TomaszUrban99/evaluation_boards/README.md

# evaluation_boards
A GitHub repository featuring example projects for various evaluation and development boards.
