TomaszUrban99/evaluation_boards/STM8S005K6CTR/parts_list.ods

LP | Description | Mouser No. | Manufacturer No. | Qty (needed) | Qty (ordered) | Price per Unit | Price (Total) | Category
1 | Switching Voltage Regulators HI EFF 500MA STEP- D OWN VLTG REG A 926-LM2671MX50NOPB | 926-LM2671M-5.0/NOPB | LM2671M-5.0/NOPB | 2 | 3 | 20.43 | 61.29 | Switching Voltage Regulators
2 | Power Inductors - SMD WE-TPC 1028 150uH .85A .53Ohm | 710-744065151 | 744065151 | 1 | 4 | 4.39 | 17.56 | Inductors
3 | Schottky Diodes & Rectifiers RECTIFIER SOD323F/SOD323F | 771-PMEG6010CEJ-T/R | PMEG6010CEJ,115 | 1 | 10 | 0.443 | 4.43 | Schottky Diode
4 | Aluminium Electrolytic Capacitors - Radial Leaded WCAP-PT5H 120uF 35V 20% Radial | 710-870235675006 | 870235675006 | 1 | 5 | 6.49 | 32.45 | Capacitors
5 | Aluminium Electrolytic Capacitors - Radial Leaded 100VDC 100uF 20% L/S=5mm | 667-EEU-FR2A101 | EEU-FR2A101 | 1 | 10 | 2.25 | 22.5 | Capacitors
6 | Multilayer Ceramic Capacitors MLCC - SMD/SMT 0.01 uF 50 VDC 10% 0603 X7R AEC-Q200 | 81-GCM188R71H103KA7J | GCM188R71H103KA37J | 1 | 20 | 0.163 | 3.26 | Capacitors
7 | Tactile Switches 4.5X4.5mm, 2.5N, Total Height 7mm, IP5X | 611-PTS647SK70SMTR2N | PTS647SK70SMTR2N LFS |  |  |  | 0
8 | Crystals 8.000 MHz 8pF +/-10/150 ppm -40 - +150C +/-2 ppm Aging AEC-Q200 ECX-33B2Q RoHS | 520-80833B2QCVYTR | ECS-80-8-33B2Q-CVY-TR3 | 1 | 10 | 1.65 | 16.5 | Crystal
9 | Multilayer Ceramic Capacitors MLCC - SMD/SMT 100V 0.1uF 10% X7R -55 / +125 0805 AEC-Q200 | 80-C0805Y104K1RACAUT C0805Y104K1RACAUTO |  | 4 | 20 | 0.727 | 14.54 | Capacitors
10 | Aluminium Electrolytic Capacitors - Radial Leaded WCAP-ATG5 1uF 63V 20% Radia | 710-860020772005 | 860020772005 | 1 | 10 | 0.439 | 4.39 | Capacitors
11 | Multilayer Ceramic Capacitors MLCC - SMD/SMT Automotive Grade,MLCC,0603,X7R,50V,1uF,+/-10%,0.8mm | 810-CGA3E3X7R1H105K0 | CGA3E3X7R1H105K080AB | 1 | 10 | 0.701 | 7.01 | Capacitors
12 | LDO Voltage Regulators Ultra-Low Noise 200mA LDO | 584-ADPL40502AUJZ33R | ADPL40502AUJZ-3.3-R7 | 2 | 10 | 1.79 | 17.9 | LDO Voltage Regulators
13 | Multilayer Ceramic Capacitors MLCC - SMD/SMT CGA 0603 50V 0.1uF X7R 10% AEC-Q200 | 810-CGA3E2X7R1H104K | CGA3E2X7R1H104K080AA | 10 | 100 | 0.095 | 9.5 | Capacitors
14 | Tantalum Capacitors - Solid SMD 35V 1uF 10% | 581-TRJB105K035RRJ | TRJB105K035RRJ | 1 | 10 | 1.57 | 15.7 | Capacitors
15 | Multilayer Ceramic Capacitors MLCC - SMD/SMT 50V 6pF C0G 0402 0.25pF | 80-C0402C609C5GACTU | C0402C609C5GACTU | 2 | 20 | 0.667 | 13.34 | Capacitors
16 |  |  |  |  |  |  | 0
 |  |  |  |  |  |  | 0
