TomaszUrban99/evaluation_boards/components/ADPL40502AUJZ-3.3-R7/3D/ADPL40502AUJZ-3.3-R7.stp

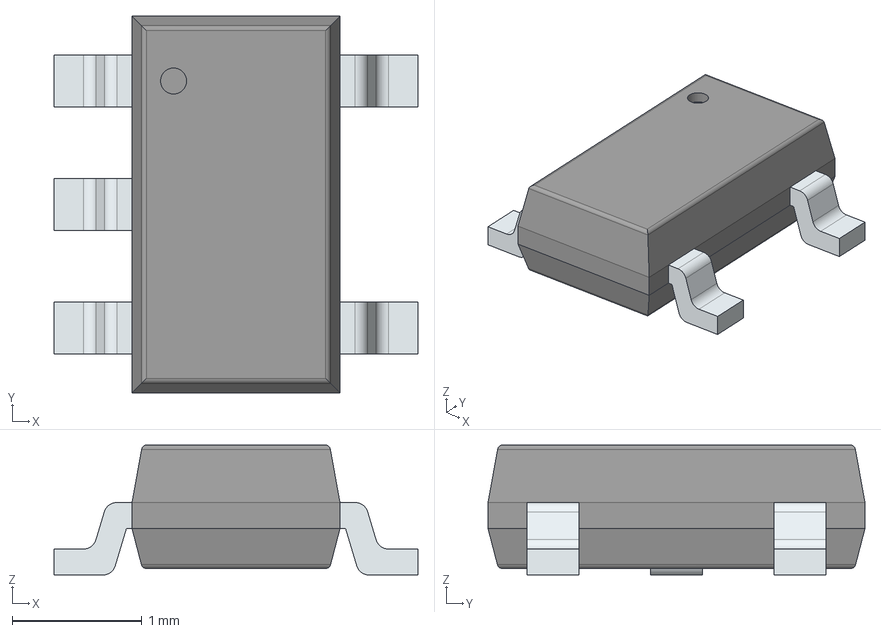
[picture p1: CAD file, 2025-09-21]
components/ADPL40502AUJZ-3.3-R7/3D/ADPL40502AUJZ-3.3-R7.stp
2.80 x 2.90 x 1.00 mm
PinsArrayL
PinsArrayR
