TomaszUrban99/evaluation_boards/components/ECS-80-8-33B2Q-CVY-TR3/3D/ECS-80-8-33B2Q-CVY-TR3.stp

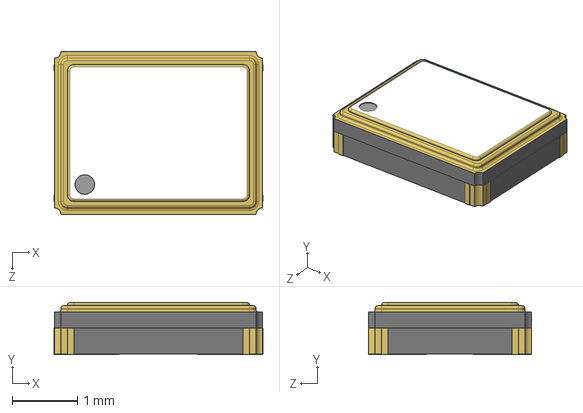
[picture p2: CAD file, 2025-09-21]
components/ECS-80-8-33B2Q-CVY-TR3/3D/ECS-80-8-33B2Q-CVY-TR3.stp
3.21 x 0.8 x 2.51 mm
