TomaszUrban99/evaluation_boards/components/L6981C50DR/3D/L6981C50DR.stp

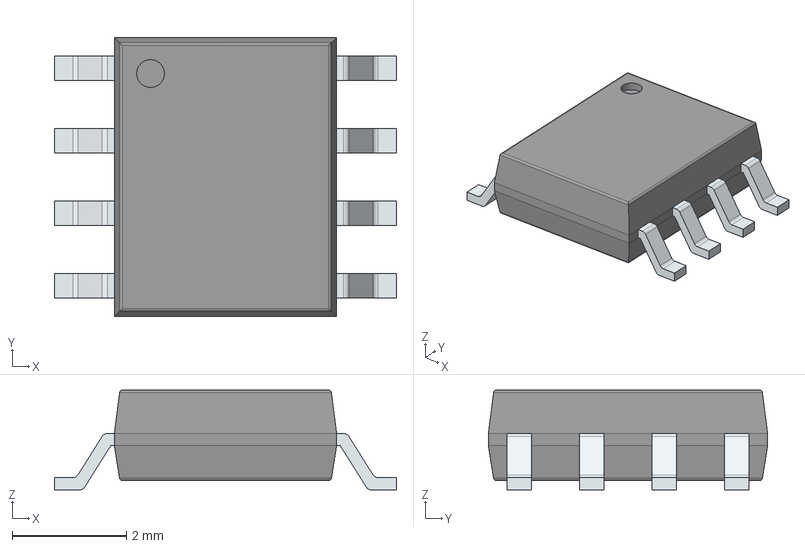
[picture p3: CAD file, 2025-09-05]
components/L6981C50DR/3D/L6981C50DR.stp
6.00 x 4.90 x 1.75 mm
PinsArrayLR
