TomaszUrban99/evaluation_boards/components/LM2671M-5.0_NOPB/3D/LM2671M-5.0_NOPB.stp

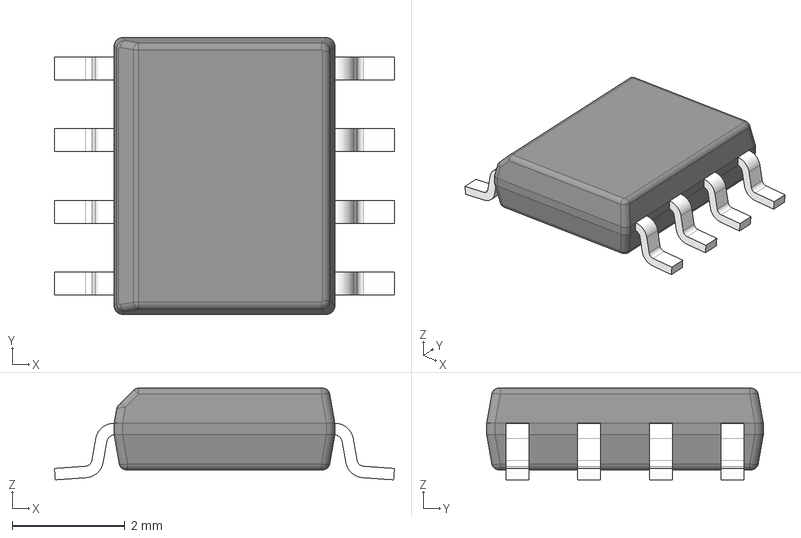
[picture p4: CAD file, 2025-09-11]
components/LM2671M-5.0_NOPB/3D/LM2671M-5.0_NOPB.stp
6.02 x 4.90 x 1.63 mm
BODY-SO
LEAD-D0008A x 8
