TomaszUrban99/evaluation_boards/components/PTS647SK70SMTR2N_LFS/3D/PTS647SK70SMTR2N_LFS.stp

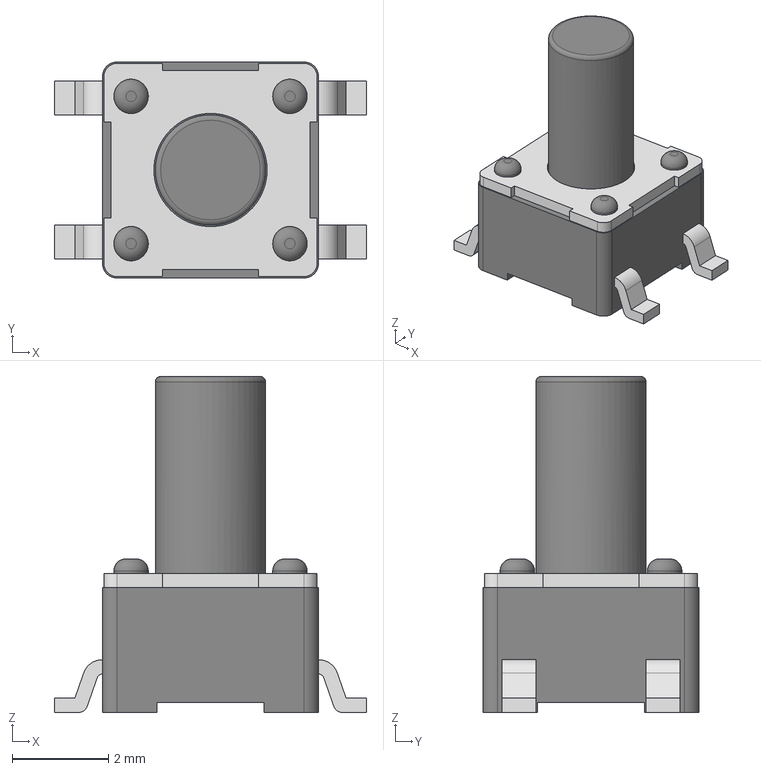
[picture p5: CAD file, 2025-09-14]
components/PTS647SK70SMTR2N_LFS/3D/PTS647SK70SMTR2N_LFS.stp
6.50 x 4.50 x 7.00 mm
