TomaszUrban99/evaluation_boards/components/STM8S005K6T6CTR/3D/STM8S005K6T6CTR.stp

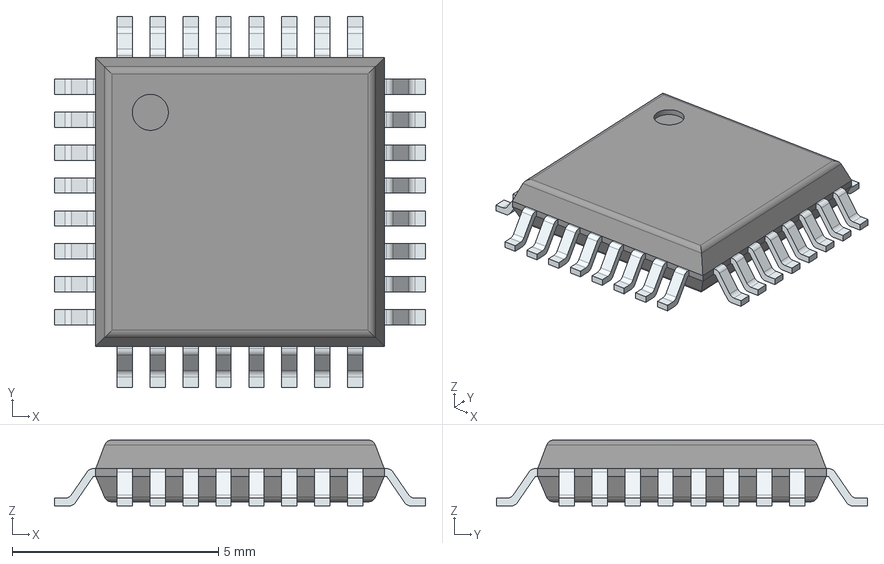
[picture p6: CAD file, 2025-09-05]
components/STM8S005K6T6CTR/3D/STM8S005K6T6CTR.stp
9.00 x 9.00 x 1.60 mm
PinsArrayLR
PinsArrayTB
