TomaszUrban99/evaluation_boards/components/282837-2/3D/282837-2.stp

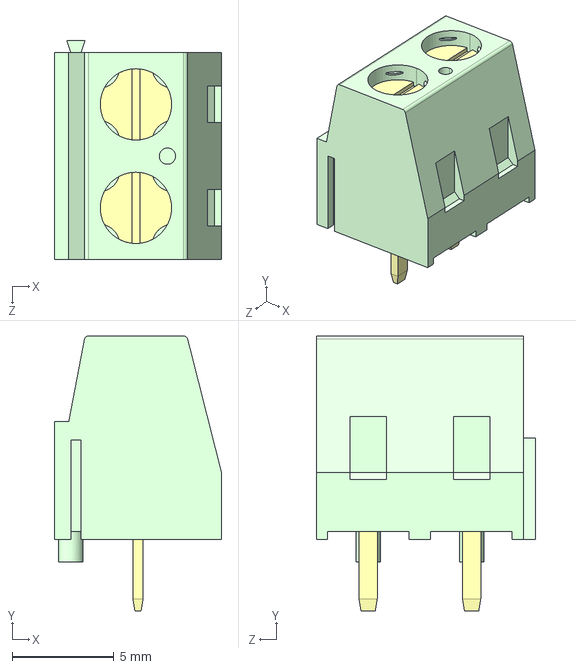
[picture p7: CAD file, 2025-09-05]
components/282837-2/3D/282837-2.stp
8.20 x 13.5 x 10.8 mm
