TomaszUrban99/evaluation_boards/components/744065151/3D/744065151.stp

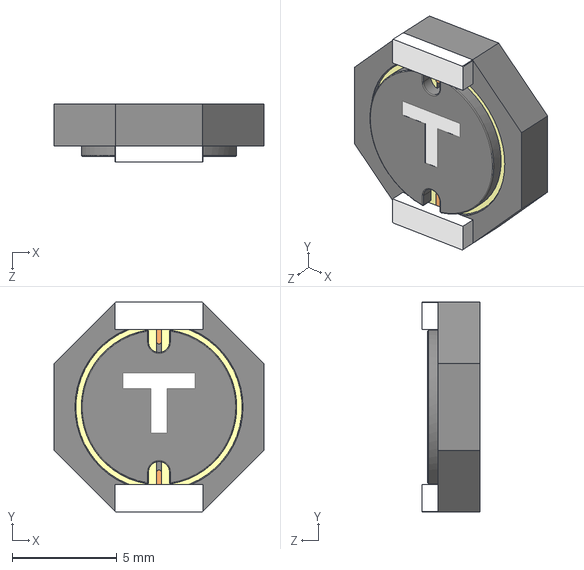
[picture p8: CAD file, 2025-09-11]
components/744065151/3D/744065151.stp
10.0 x 10.0 x 2.78 mm
