TomaszUrban99/evaluation_boards/components/830029914/3D/830029914.stp

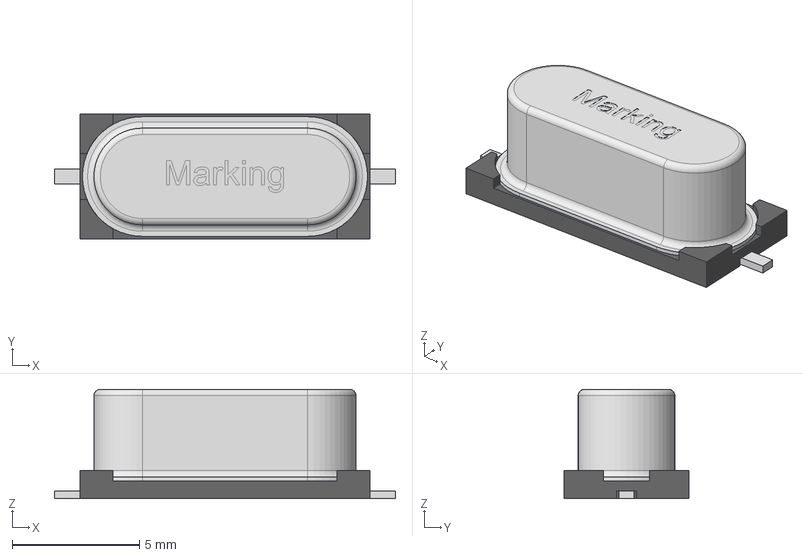
[picture p9: CAD file, 2025-09-14]
components/830029914/3D/830029914.stp
13.4 x 4.90 x 4.30 mm
Base
Housing
