TomaszUrban99/evaluation_boards/(list of files, cad)

Other CAD files:
components/830029914/Allegro/830029914.psm
components/830029914/DEHDL/830029914/chips/chips.prt
