TomaszUrban99/evaluation_boards/STM8S005K6CTR/STM8S005k6T6CTR.kicad_pcb

## KiCad design STM8S005K6CTR/STM8S005k6T6CTR.kicad_pcb (2025-09-25)

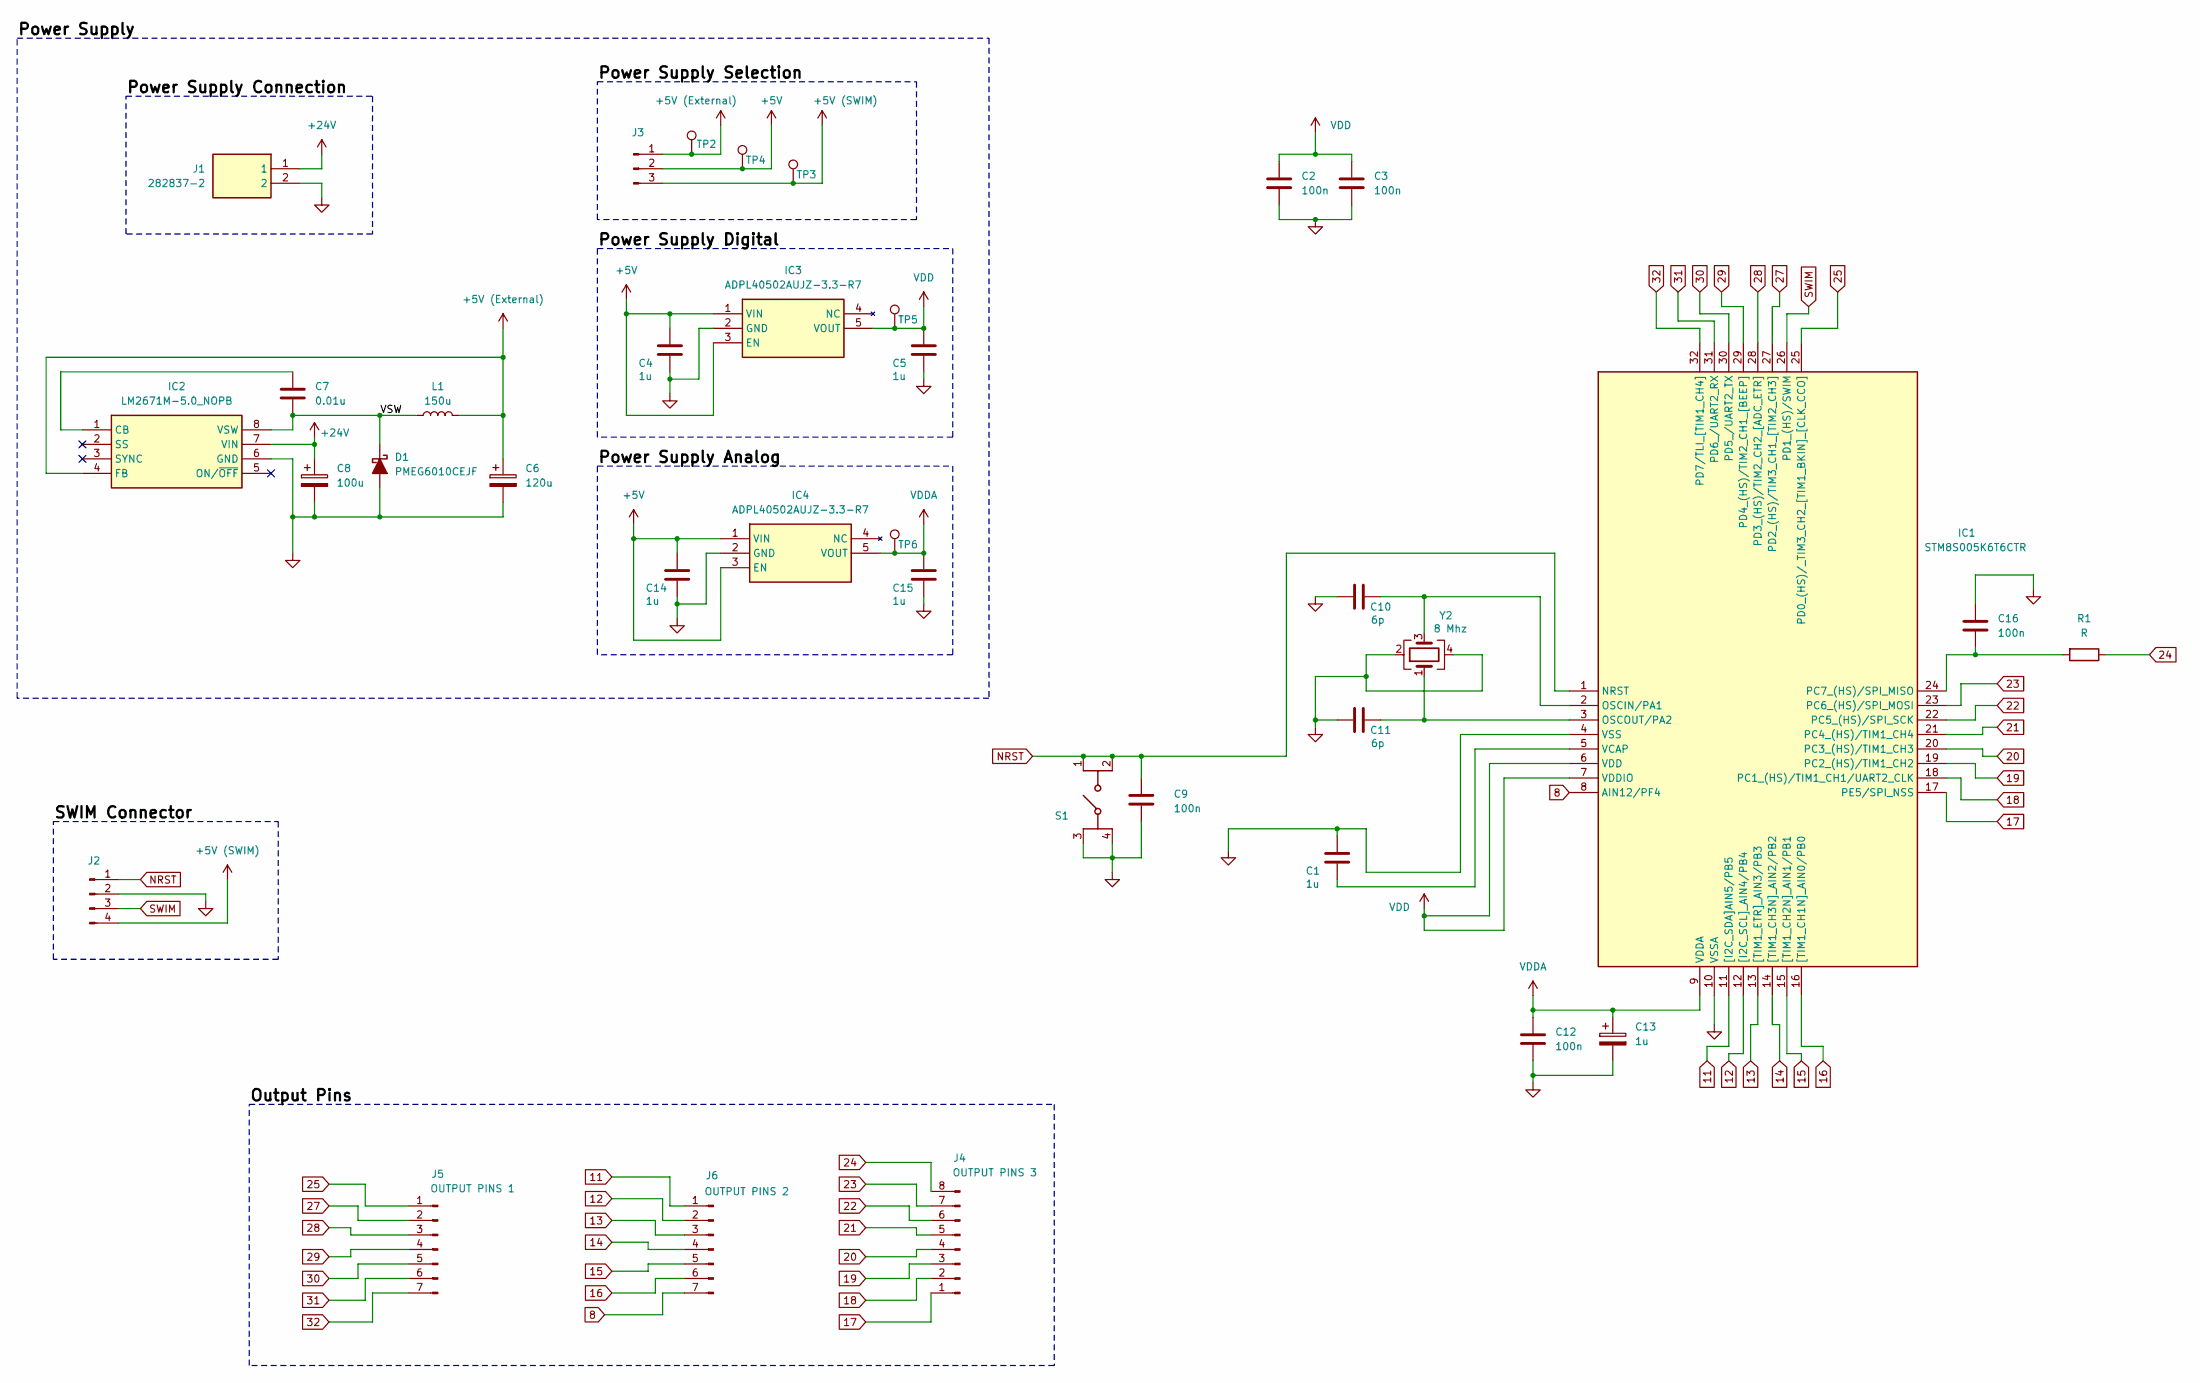
[picture p10: schematic STM8S005k6T6CTR.kicad_sch]

Parts:
C1, C4, C5, C14, C15: 1u; C_0603_1608Metric
C2, C3, C9, C12, C16: 100n; C_0603_1608Metric
C6: 120u; CP_Radial_D10.0mm_P5.00mm
C7: 0.01u; C_0603_1608Metric
C8: 100u; CP_Radial_D10.0mm_P5.00mm
C10, C11: 6p; C_0402_1005Metric
C13: 1u; C_1210_3225Metric
D1: PMEG6010CEJF; D_SOD-323F
IC1: STM8S005K6T6CTR; QFP80P900X900X160-32N; Mouser Part Number 511-STM8S005K6T6CTR
IC2: LM2671M-5.0_NOPB; SOIC127P600X175-8N; Mouser Part Number 926-LM2671M-5.0/NOPB
IC3, IC4: ADPL40502AUJZ-3.3-R7; SOT95P280X100-5N; Mouser Part Number 584-ADPL40502AUJZ33R
J1: 282837-2; 2828372; Mouser Part Number 571-2828372
J2: Conn_01x04_Pin; PinHeader_1x04_P2.54mm_Vertical
J3: Conn_01x03_Pin; PinHeader_1x03_P2.54mm_Vertical
J4: Conn_01x08_Pin; PinSocket_1x08_P2.54mm_Vertical
J5, J6: Conn_01x07_Pin; PinSocket_1x07_P2.54mm_Vertical
L1: 150u; WE-TPC_1028_103892
R1: R
S1: PTS647SK70SMTR2N_LFS; PTS647SK70SMTR2NLFS; Manufacturer_Part_Number PTS647SK70SMTR2N LFS
TP2, TP3, TP4, TP5, TP6: TestPoint; TestPoint_Pad_D1.5mm
Y2: 8 Mhz; ECS80833B2QCVYTR3

Connections:
8: IC1.8 (AIN12/PF4), J6.7
11: IC1.11 ([I2C_SDA]AIN5/PB5), J6.1
12: IC1.12 ([I2C_SCL]_AIN4/PB4), J6.2
13: IC1.13 ([TIM1_ETR]_AIN3/PB3), J6.3
14: IC1.14 ([TIM1_CH3N]_AIN2/PB2), J6.4
15: IC1.15 ([TIM1_CH2N]_AIN1/PB1), J6.5
16: IC1.16 ([TIM1_CH1N]_AIN0/PB0), J6.6
17: IC1.17 (PE5/SPI_NSS), J4.1
18: IC1.18 (PC1_(HS)/TIM1_CH1/UART2_CLK), J4.2
19: IC1.19 (PC2_(HS)/TIM1_CH2), J4.3
20: IC1.20 (PC3_(HS)/TIM1_CH3), J4.4
21: IC1.21 (PC4_(HS)/TIM1_CH4), J4.5
22: IC1.22 (PC5_(HS)/SPI_SCK), J4.6
23: IC1.23 (PC6_(HS)/SPI_MOSI), J4.7
24: J4.8, R1.1
25: IC1.25 (PD0_(HS)/_TIM3_CH2_[TIM1_BKIN]_[CLK_CCO]), J5.1
27: IC1.27 (PD2_(HS)/TIM3_CH1_[TIM2_CH3]), J5.2
28: IC1.28 (PD3_(HS)/TIM2_CH2_[ADC_ETR]), J5.3
29: IC1.29 (PD4_(HS)/TIM2_CH1_[BEEP]), J5.4
30: IC1.30 (PD5_/UART2_TX), J5.5
31: IC1.31 (PD6_/UART2_RX), J5.6
32: IC1.32 (PD7/TLI_[TIM1_CH4]), J5.7
+5V: C4.1, C14.1, IC3.1 (VIN), IC3.3 (EN), IC4.1 (VIN), IC4.3 (EN), J3.2, TP4.1
+5V (External): C6.1, IC2.4 (FB), J3.1, L1.2, TP2.1
+5V (SWIM): J2.4, J3.3, TP3.1
+24V: C8.1, IC2.7 (VIN), J1.1
GND: C1.1, C2.2, C3.2, C4.2, C5.2, C6.2, C8.2, C9.2, C10.2, C11.2, C12.2, C13.2, C14.2, C15.2, C16.1, D1.2 (A), IC1.4 (VSS), IC1.10 (VSSA), IC2.6 (GND), IC3.2 (GND), IC4.2 (GND), J1.2, J2.2, S1.3 (COM_1), S1.4 (COM_2), Y2.2, Y2.4
NRST: C9.1, IC1.1 (NRST), J2.1, S1.1 (NO_1), S1.2 (NO_2)
unnamed: C7.1, D1.1 (K), IC2.8 (VSW), L1.1
unnamed: C10.1, IC1.2 (OSCIN/PA1), Y2.3
unnamed: C11.1, IC1.3 (OSCOUT/PA2), Y2.1
unnamed: C16.2, IC1.24 (PC7_(HS)/SPI_MISO), R1.2
unnamed: C1.2, IC1.5 (VCAP)
unnamed: C7.2, IC2.1 (CB)
SWIM: IC1.26 (PD1_(HS)/SWIM), J2.3
VDD: C2.1, C3.1, C5.1, IC1.6 (VDD), IC1.7 (VDDIO), IC3.5 (VOUT), TP5.1
VDDA: C12.1, C13.1, C15.1, IC1.9 (VDDA), IC4.5 (VOUT), TP6.1

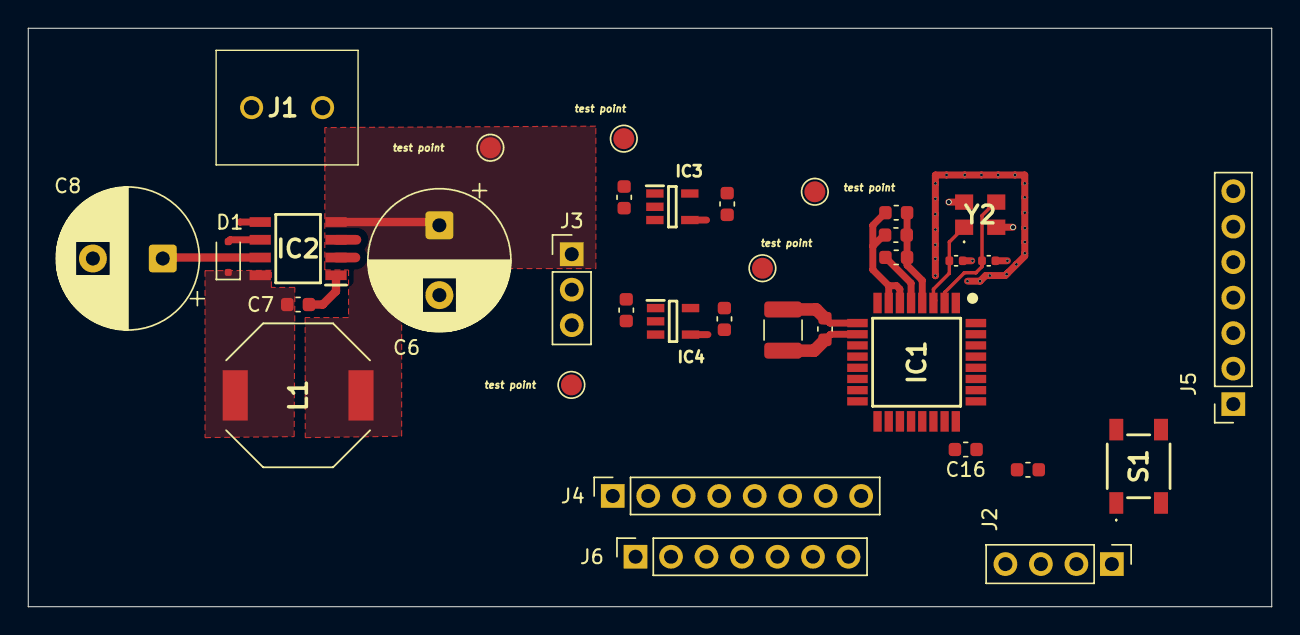
[picture p11: board STM8S005k6T6CTR.kicad_pcb from above]

Board: 2 copper layers, 89.0 x 41.4 mm, 35 parts (0 on the bottom side), 36 nets.
