TomaszUrban99/evaluation_boards/(commit log)

2025-09-05 [STM8S005K6t6CTR] Added 8-bit uC. Added L6981 voltage switch regulator with component's values.
    [282837-2.stp, L6981C50DR.stp, STM8S005K6T6CTR.stp, STM8S005k6T6CTR.kicad_pcb, STM8S005k6T6CTR.kicad_sch]
2025-09-11 [STM8S005K6T6CTR] Calculations: calculated values of components for switching voltage regulator - TI LM2671. Board scheme: Added switching voltage regulator with additional components. Assigned footp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
    [744065151.stp, LM2671M-5.0_NOPB.stp, STM8S005k6T6CTR.kicad_pcb, STM8S005k6T6CTR.kicad_sch, parts_list.ods]
2025-09-11 [STM8S005K6T6CTR] Board scheme: Added Power Supply Selecection pins. Added SWIM connector.
    [STM8S005k6T6CTR.kicad_sch]
2025-09-14 [STM8S005K6T6CTR] Calculations: calculated crystal components. Board scheme: Added crystal to scheme (with footprint). Added part of output pins.
    [830029914.psm, 830029914.stp, EDI2CAP.CFG, PTS647SK70SMTR2N_LFS.stp, STM8S005k6T6CTR.kicad_pcb, STM8S005k6T6CTR.kicad_sch, chips.prt, parts_list.ods]
2025-09-14 [STM8S005K6T6CTR] Board scheme: assigned footprints to decoupling capacitors and VCAP capacitor.
    [STM8S005k6T6CTR.kicad_sch, parts_list.ods]
2025-09-21 [STM8S005K6T6CTR] Board scheme: Improvements
    [ADPL40502AUJZ-3.3-R7.stp, ECS-80-8-33B2Q-CVY-TR3.stp, STM8S005k6T6CTR.kicad_sch, parts_list.ods]
2025-09-25 [STM8S005K6T6CTR] Board scheme: Footprints layout. Crystal routing.
    [STM8S005k6T6CTR.kicad_pcb, STM8S005k6T6CTR.kicad_sch, parts_list.ods]
